SethBRichards/ee453_pcb_N-B-S/README.md

# ee453_pcb_N-B-S
ee453 pcb repo for Nolan, Bennett, and Seth
