SethBRichards/ee453_pcb_N-B-S/ee453_pcb_N-B-S.pdf

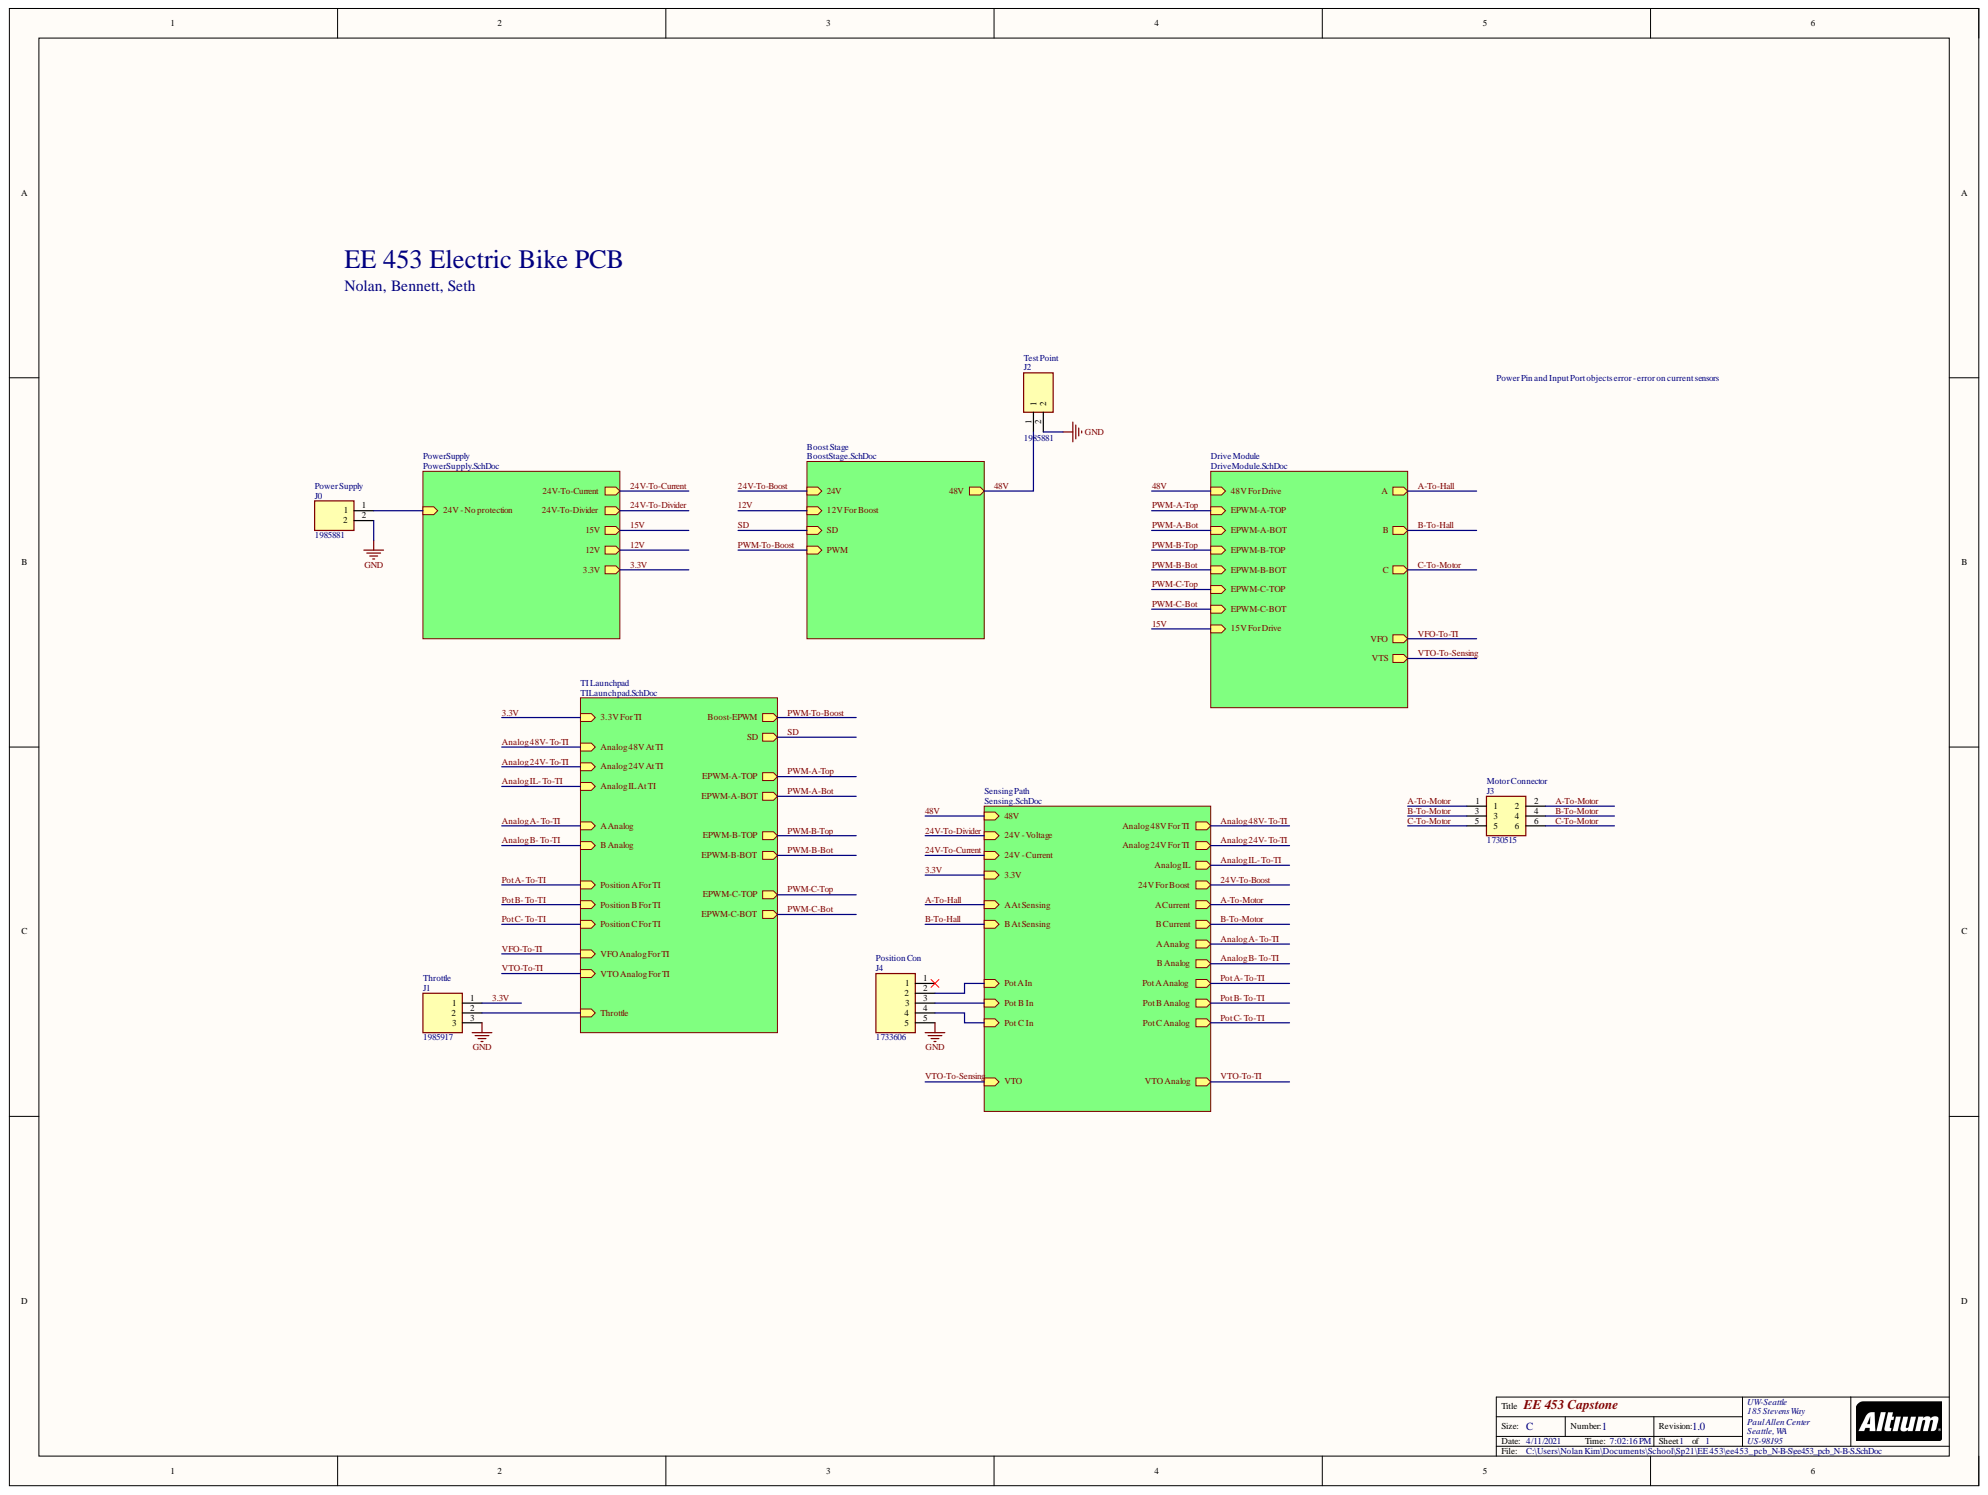
[picture p1: page 1]

EE 453 Electric Bike PCB

Power Pin and InputPort objects error - error on currentsensors

C:\Users\Nolan Kim\Documents\School\Sp21\EE453\ee453_pcb_N-B-S\ee453_pcb_N-B-S.SchDoc

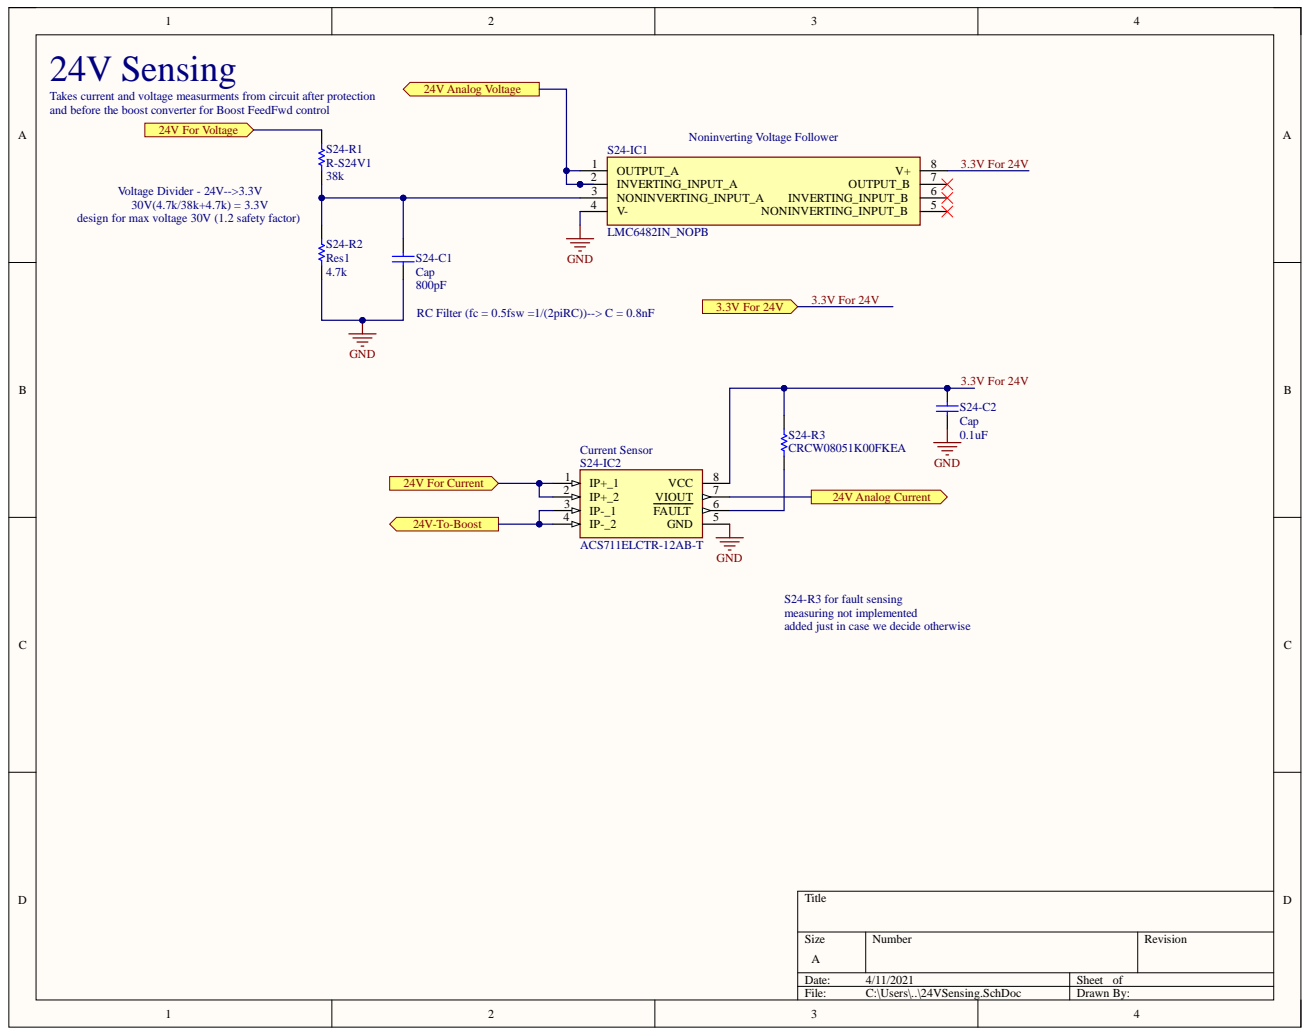
[picture p2: page 2]

Takes current and voltage measurments from circuit after protection
and before the boost converter for Boost FeedFwd control

design for max voltage 30V (1.2 safety factor)

S24-R3 for fault sensing
measuring not implemented
added just in case we decide otherwise

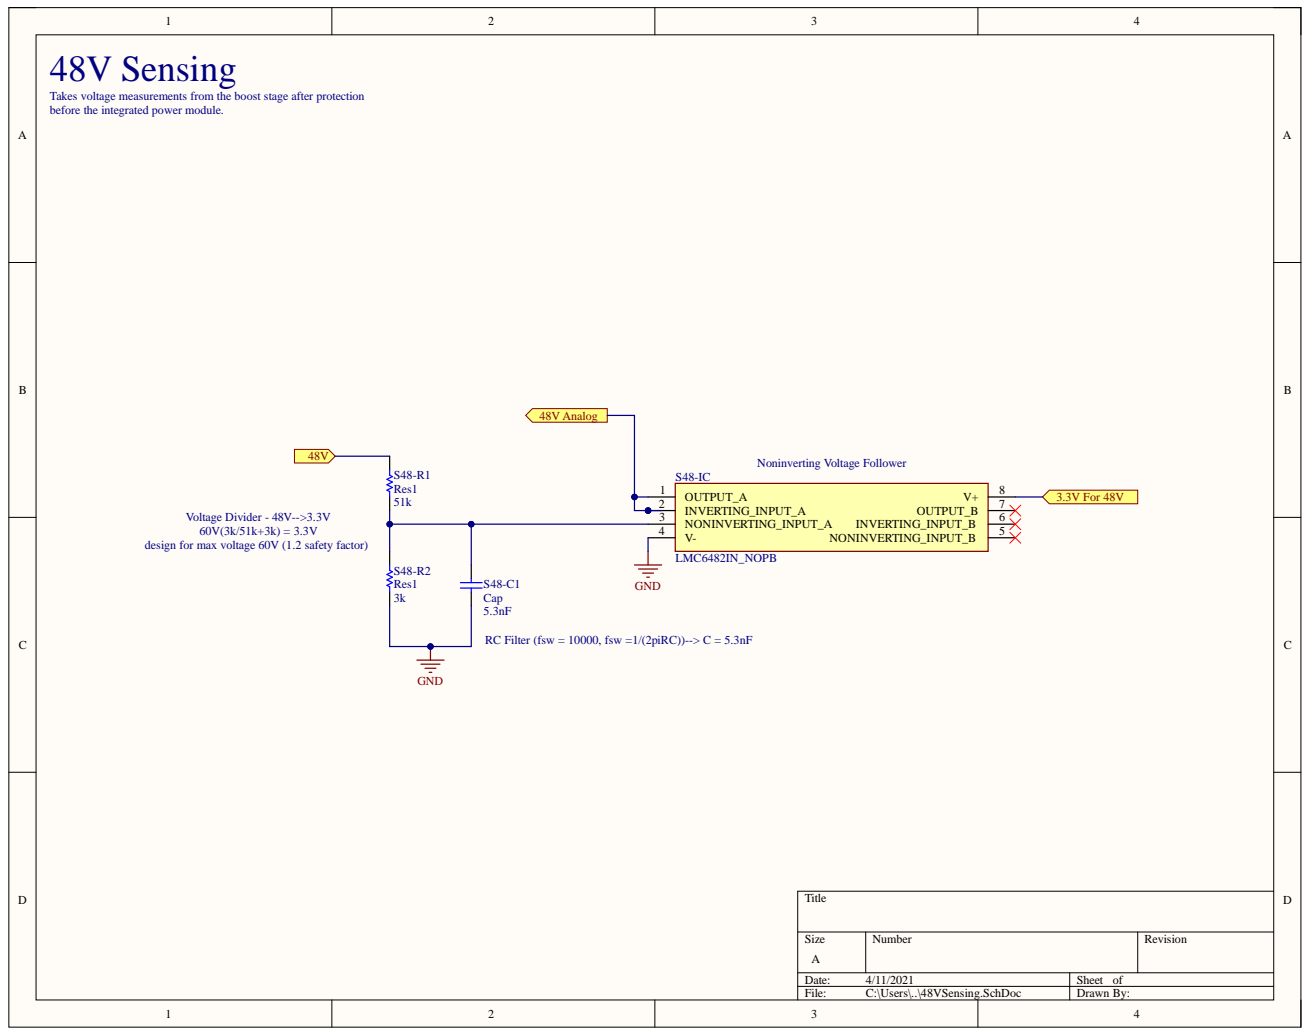
[picture p3: page 3]

48V Sensing Takes voltage measurements from the boos

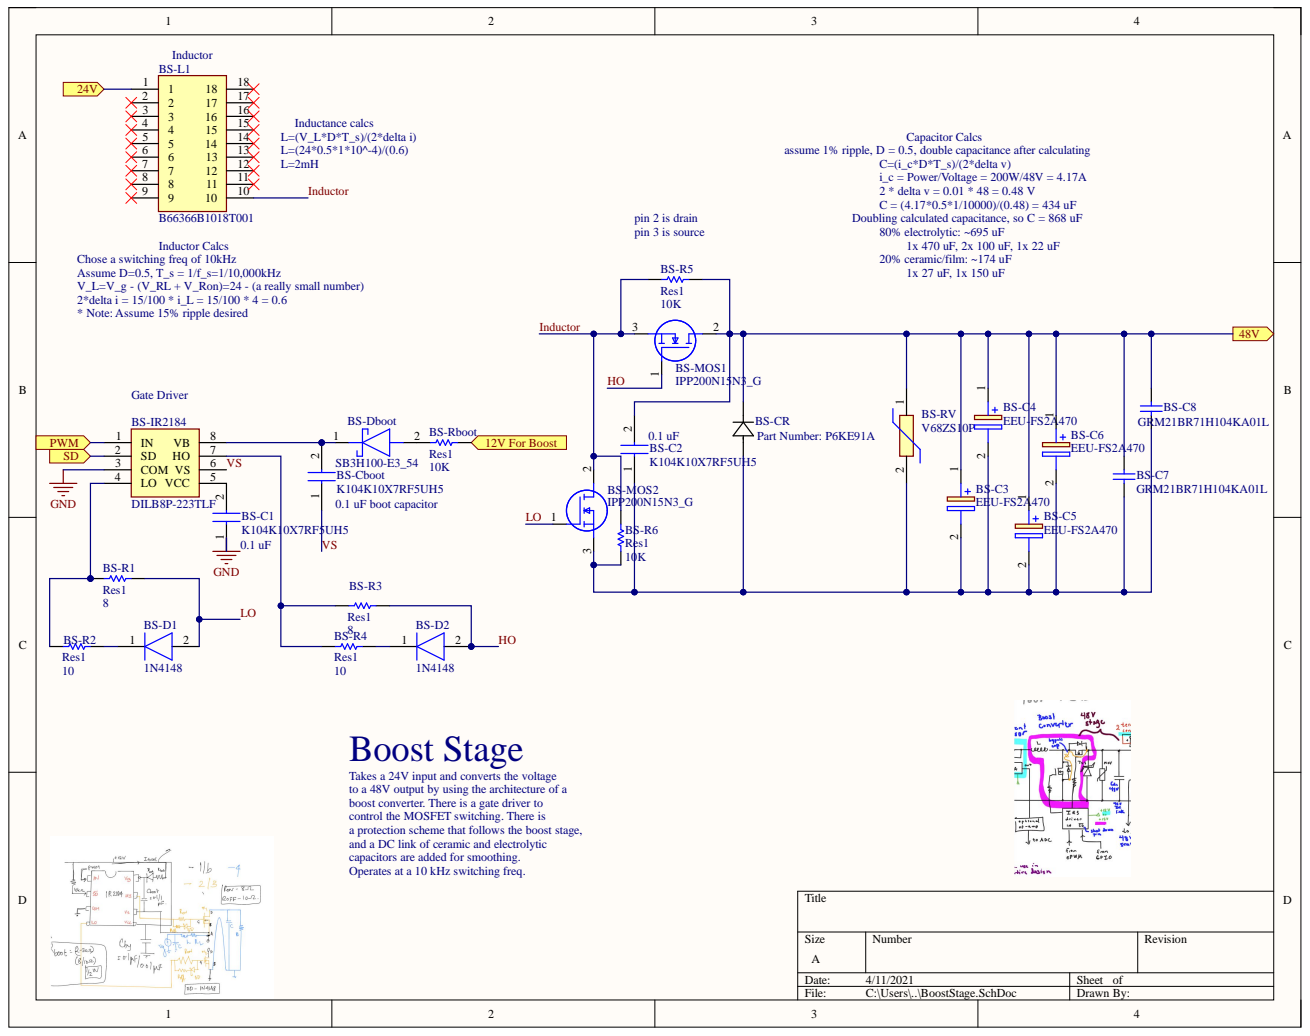
[picture p4: page 4]

assume 1% ripple, D = 0.5, double capacitance after calculating

C=(i_c*D*T_s)/(2*delta v)
i_c = Power/Voltage = 200W/48V = 4.17A
2 * delta v = 0.01 * 48 = 0.48 V
Doubling calculated capacitance, so C = 868 uF
80% electrolytic: ~695 uF
20% ceramic/film: ~174 uF

Chose a switching freq of 10kHz
Assume D=0.5, T_s = 1/f_s=1/10,000kHz
V_L=V_g - (V_RL + V_Ron)=24 - (a really small number)
2*delta i = 15/100 * i_L = 15/100 * 4 = 0.6
* Note: Assume 15% ripple desired

Takes a 24V input and converts the voltage
to a 48V output by using the architecture of a
boost converter. There is a gate driver to
control the MOSFET switching. There is
a protection scheme that follows the boost stage,
and a DC link of ceramic and electrolytic
capacitors are added for smoothing.
Operates at a 10 kHz switching freq.

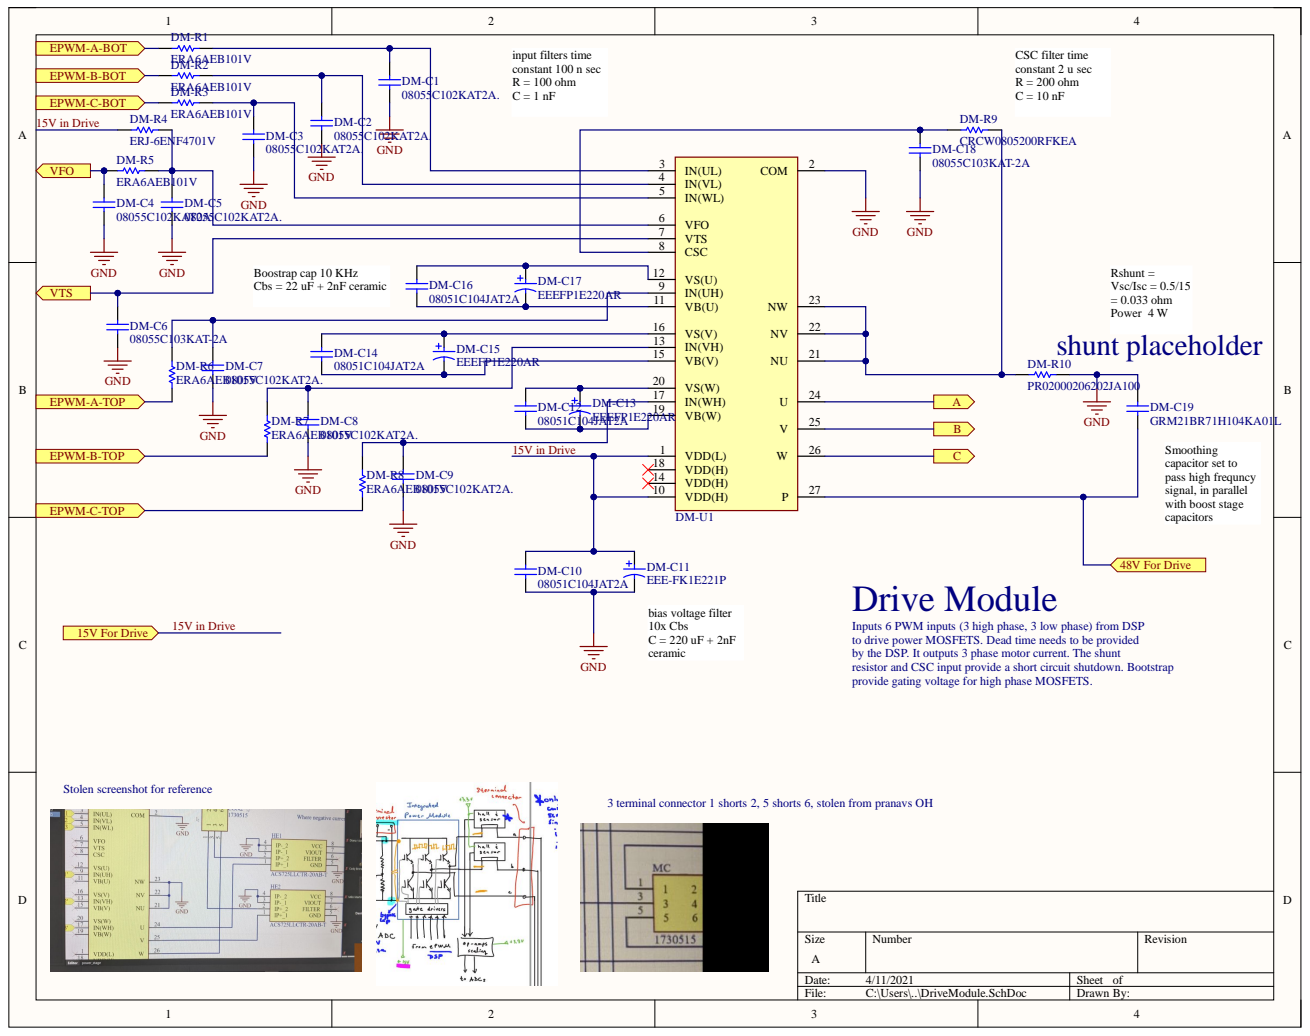
[picture p5: page 5]

D M-C15 D M-C14
08051C104J AT2A | E E E F P1E220A R

age for high pha

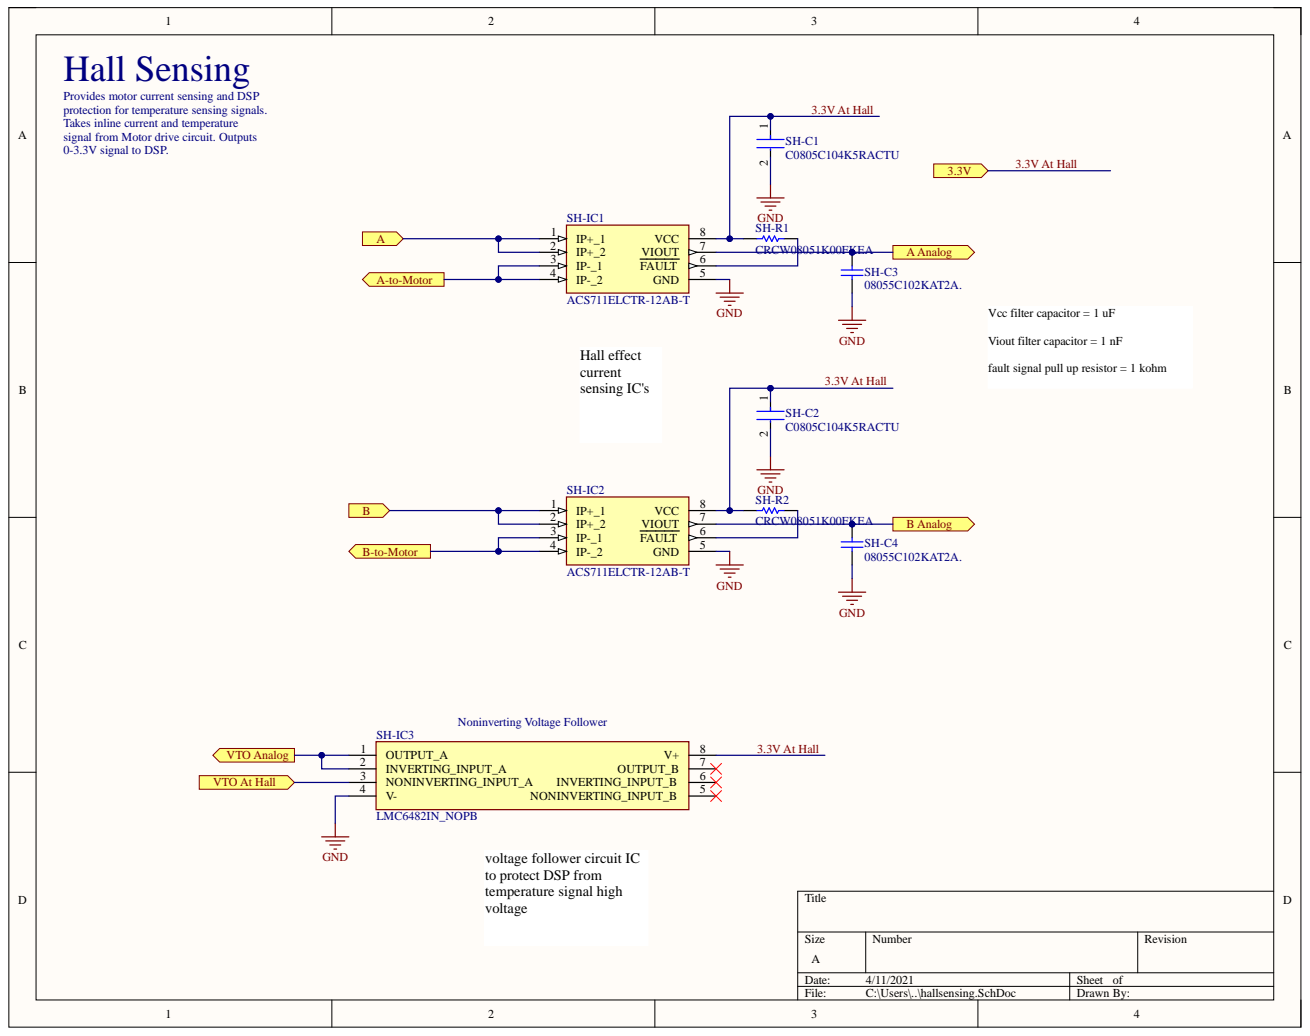
[picture p6: page 6]

Provides motor current sensing and DSP
protection for temperature sensing signals.
Takes inline current and temperature
signal from Motor drive circuit. Outputs
0-3.3V signal to DSP.

Vcc filter capacitor = 1 uF

Viout filter capacitor = 1 nF

fault signal pull up resistor = 1 kohm

voltage follower circuit IC
to protect DSP from
temperature signal high
voltage

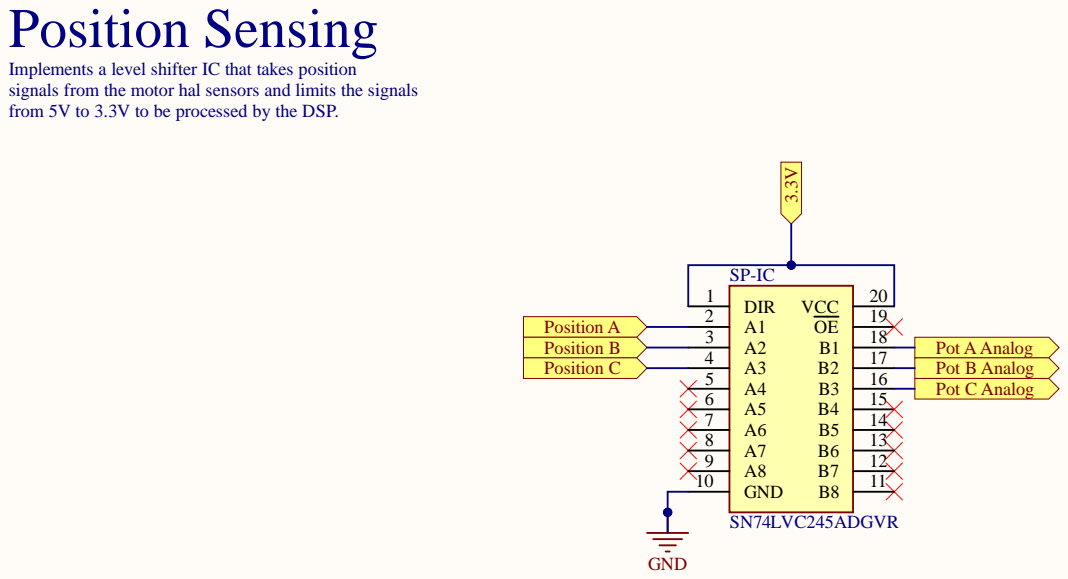
[picture p7: page 7]

Implements a level shifter IC that takes position
signals from the motor hal sensors and limits the signals
from 5V to 3.3V to be processed by the DSP.

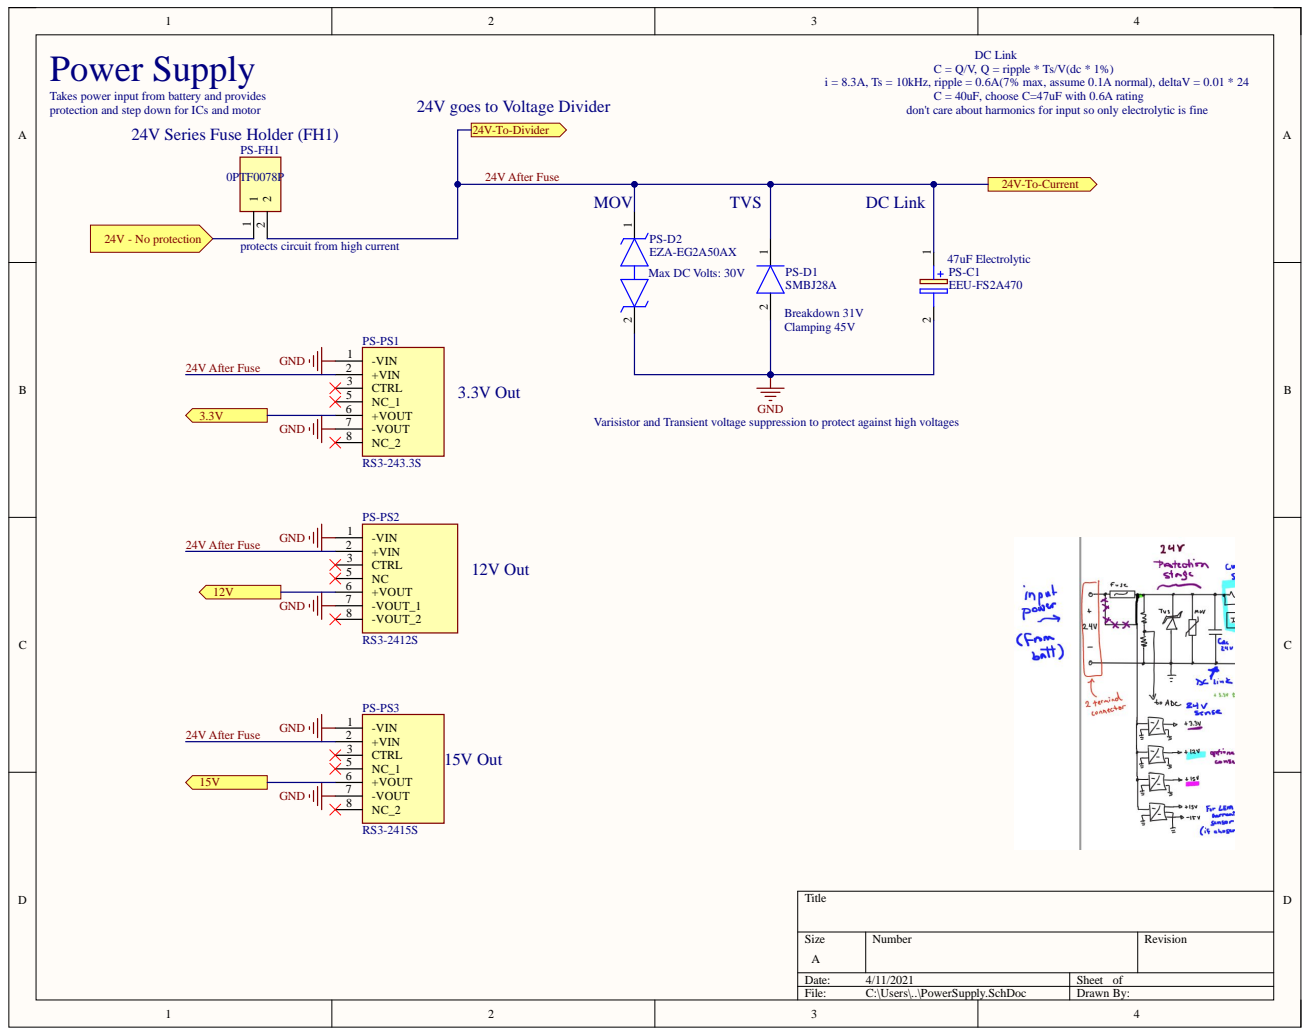
[picture p8: page 8]

i = 8.3A, Ts = 10kHz, ripple = 0.6A(7% max, assume 0.1A normal), deltaV = 0.01 * 24

Takes power input from battery and provides
protection and step down for ICs and motor

24V goes to Voltage Divider

C = 40uF, choose C=47uF with 0.6A rating
don't care about harmonics for input so only electrolytic is fine

protects circuit from high current

Varisistor and Transient voltage suppression to protect against high voltages

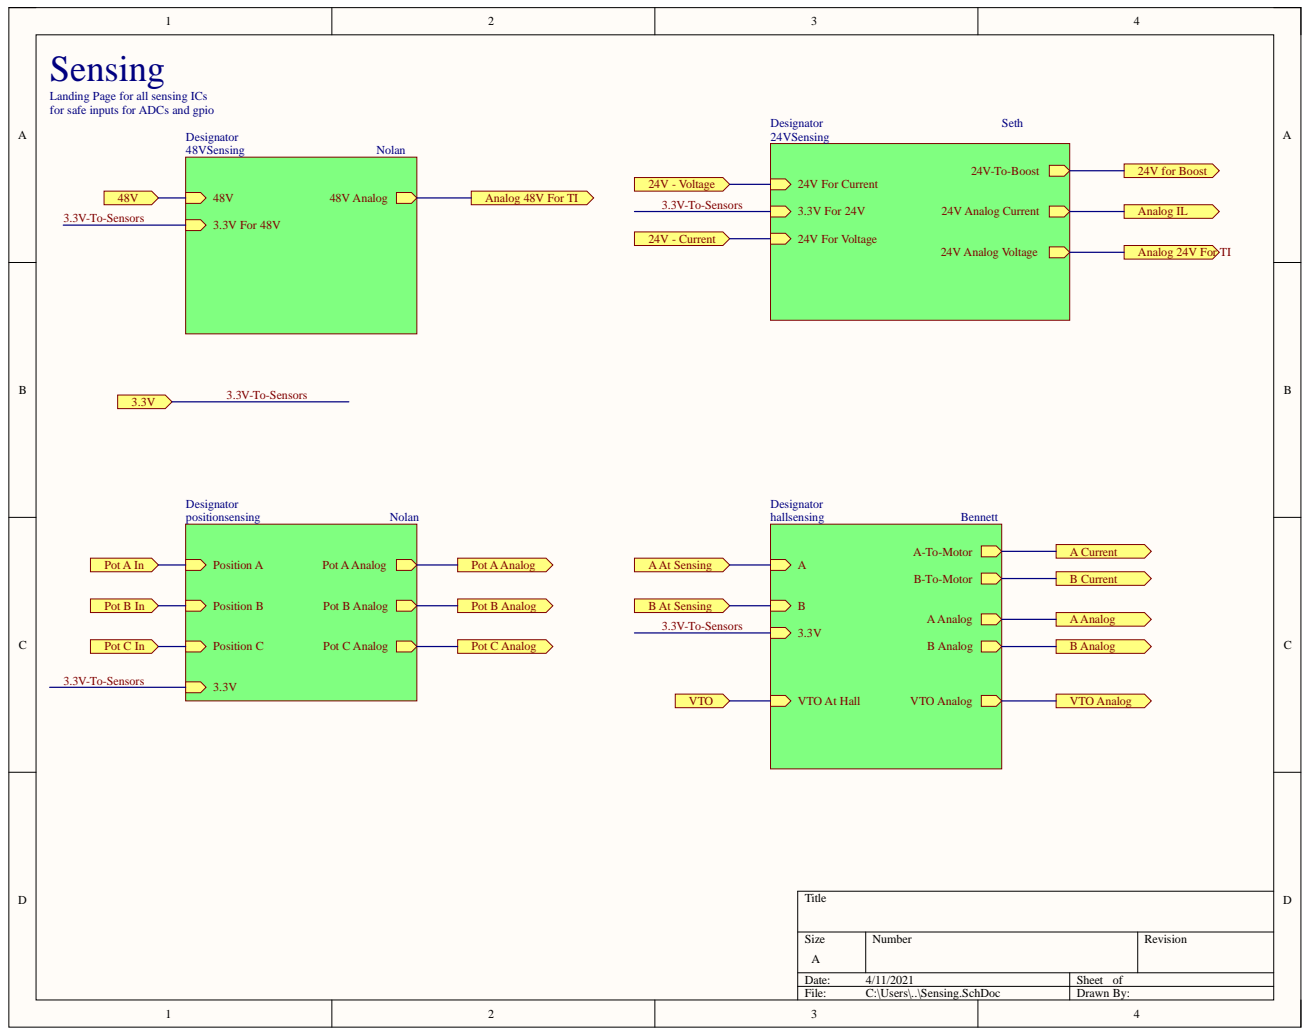
[picture p9: page 9]

Landing Page for all sensing ICs
for safe inputs for ADCs and gpio

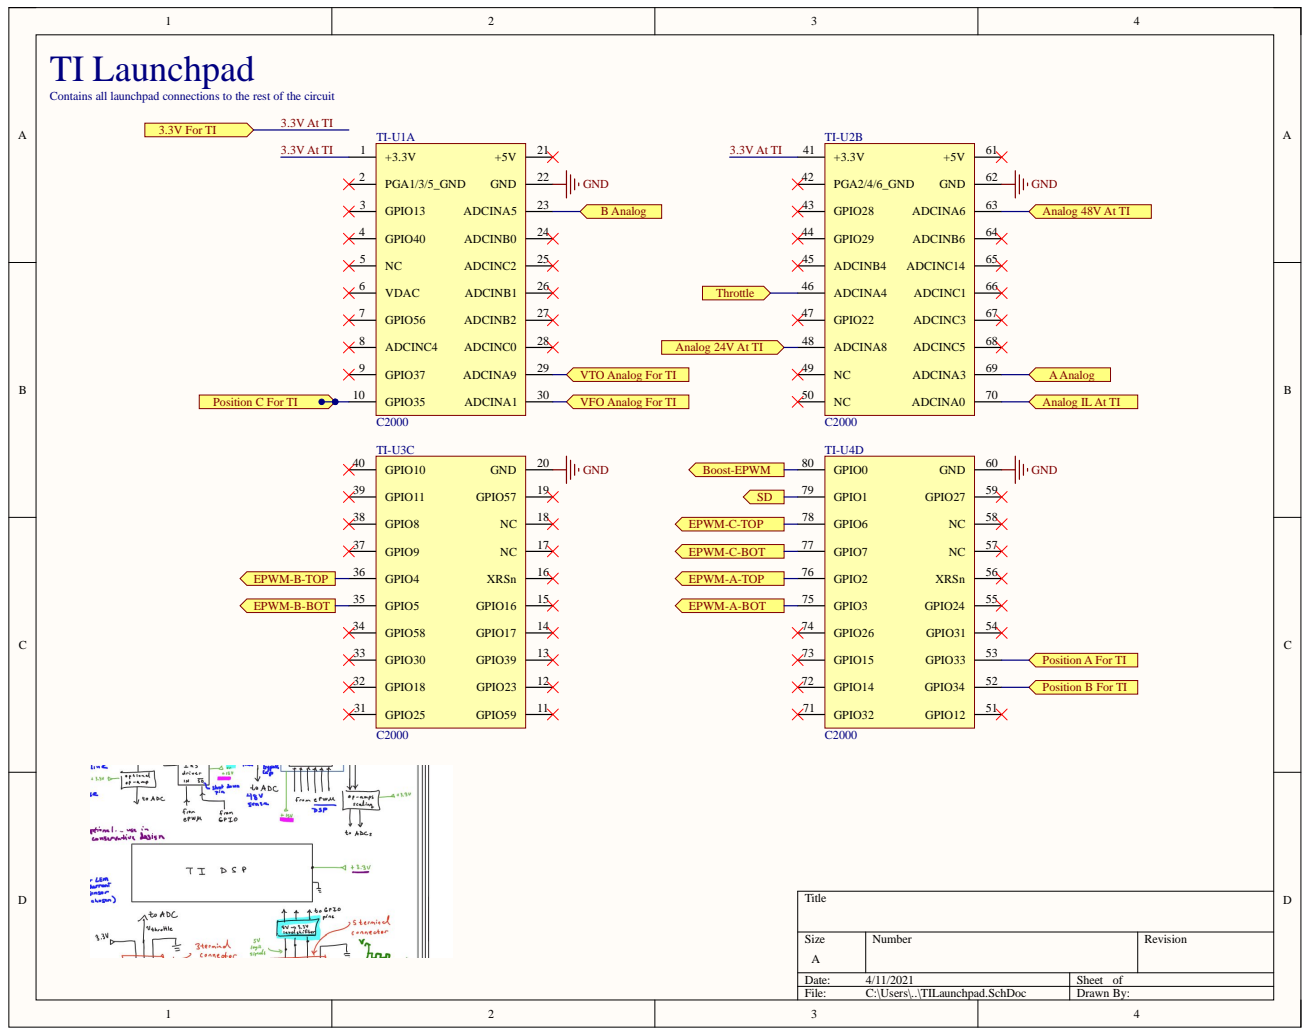
[picture p10: page 10]

Contains all launchpad connections to the rest of the circuit

VTO Analog For TI

VFO Analog For TI

Analog IL At TI

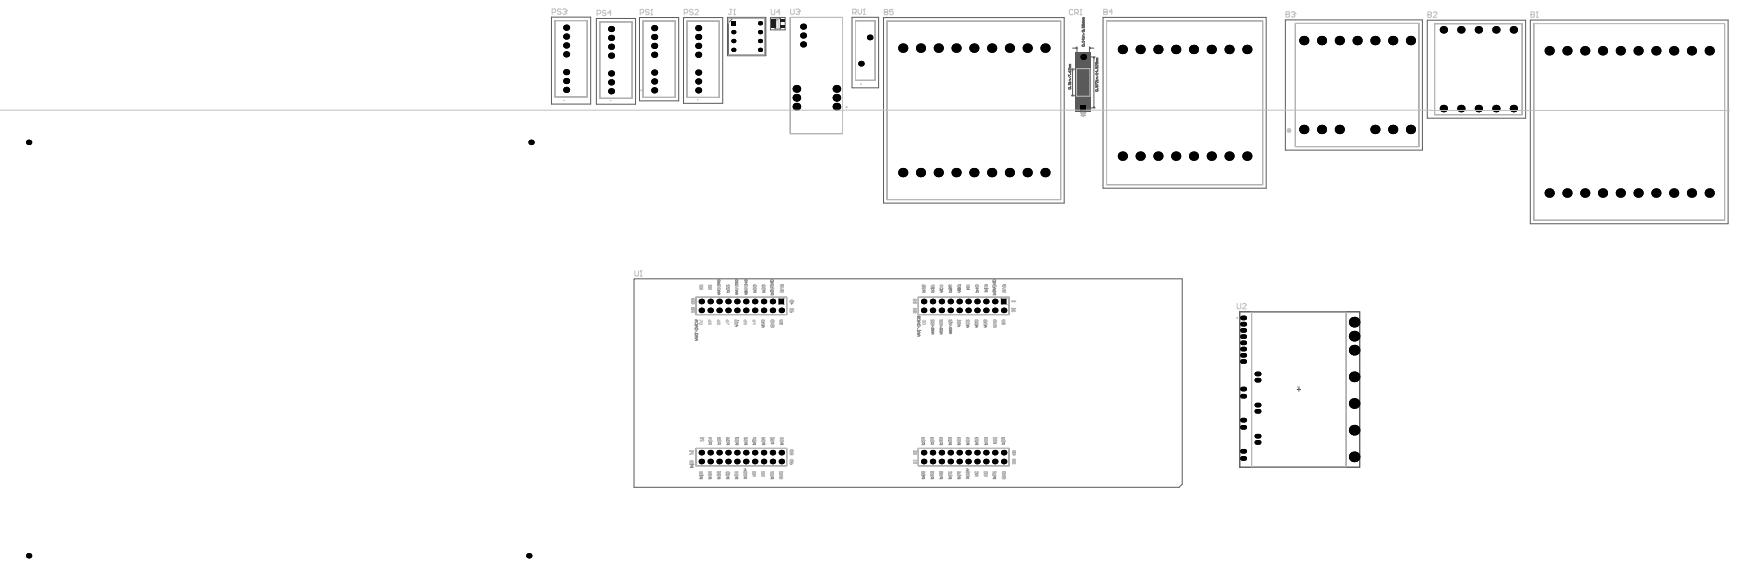
[picture p11: page 11]
