SethBRichards/ee453_pcb_N-B-S/(list of files, drawings)

Other design files:
BoostStage.SchDoc
DriveModule.SchDoc
ee453_pcb_N-B-S.PcbDoc
ee453_pcb_N-B-S.PrjPcb
ee453_pcb_N-B-S.SchDoc
ee_453_yourname.PcbLib
ee_453_yourname.SchLib
hallsensing.SchDoc
positionsensing.SchDoc
PowerSupply.SchDoc
Sensing.SchDoc
TILaunchpad.SchDoc
VoltageSensing.SchDoc
