SethBRichards/ee453_pcb_N-B-S/(commit log)

2021-04-07 Added Altium Files
    Added altium files from template with
    sub circuit schematic files
    [BoostStage.SchDoc, DriveModule.SchDoc, PowerSupply.SchDoc, Sensing.SchDoc, TILaunchpad.SchDoc, ee453_pcb_N-B-S.PcbDoc, ee453_pcb_N-B-S.PrjPcb, ee453_pcb_N-B-S.SchDoc]
2021-04-07 test commit
    [ee453_pcb_N-B-S.PrjPcb, ee453_pcb_N-B-S.SchDoc]
2021-04-07 re-adding files to source
    [PowerSupply.SchDoc, ee453_pcb_N-B-S.PrjPcb]
2021-04-07 added top level entry placements
    [BoostStage.SchDoc, DriveModule.SchDoc, PowerSupply.SchDoc, Sensing.SchDoc, TILaunchpad.SchDoc, ee453_pcb_N-B-S.SchDoc]
2021-04-07 added some power supply stuff
    [PowerSupply.SchDoc, ee453_pcb_N-B-S.SchDoc]
2021-04-07 added jpgs for reference
    [BoostStage.SchDoc, DriveModule.SchDoc, PowerSupply.SchDoc, Sensing.SchDoc, TILaunchpad.SchDoc, ee453_pcb_N-B-S.SchDoc]
2021-04-07 DC link equation
    [BoostStage.SchDoc]
2021-04-07 dc link
    [BoostStage.SchDoc, PowerSupply.SchDoc]
2021-04-07 notes on dc link
    [BoostStage.SchDoc]
2021-04-07 stolen screenshots
    [BoostStage.SchDoc, DriveModule.SchDoc, TILaunchpad.SchDoc]
2021-04-07 finished power supply
    [PowerSupply.SchDoc, ee453_pcb_N-B-S.SchDoc]
2021-04-07 note on op amp
    [Sensing.SchDoc]
2021-04-07 ground -vout for ps
    [PowerSupply.SchDoc, Sensing.SchDoc, TILaunchpad.SchDoc]
2021-04-08 launchpad update
    [TILaunchpad.SchDoc, ee453_pcb_N-B-S.SchDoc]
2021-04-08 dc link update
    [PowerSupply.SchDoc, TILaunchpad.SchDoc]
2021-04-08 finished boost
    [BoostStage.SchDoc]
2021-04-08 Power module started. Inputs and outputs connected. Still working to size and itegrate resistor and capacitors.
    [DriveModule.SchDoc, ee453_pcb_N-B-S.PrjPcb]
2021-04-08 meeting updates
    [24VSensing.SchDoc, 48VSensing.SchDoc, BoostStage.SchDoc, PowerSupply.SchDoc, Sensing.SchDoc, TILaunchpad.SchDoc, ee453_pcb_N-B-S.SchDoc, hallsensing.SchDoc]
2021-04-08 added correct current paths
    [24VSensing.SchDoc, Sensing.SchDoc]
2021-04-08 updated ti ports
    [24VSensing.SchDoc, PowerSupply.SchDoc, TILaunchpad.SchDoc, ee453_pcb_N-B-S.SchDoc]
2021-04-08 gnd update
    [PowerSupply.SchDoc, TILaunchpad.SchDoc]
2021-04-08 added hall sensors
    [24VSensing.SchDoc, 48VSensing.SchDoc, PowerSupply.SchDoc, Sensing.SchDoc, hallsensing.SchDoc]
2021-04-08 added 24V I&V sensing
    [24VSensing.SchDoc, Sensing.SchDoc]
2021-04-08 finally fixed TI
    [TILaunchpad.SchDoc]
2021-04-08 i dont remember
    [TILaunchpad.SchDoc]
2021-04-09 mostly complete drive module
    [DriveModule.SchDoc]
2021-04-09 fixed power supply DC link
    [24VSensing.SchDoc, PowerSupply.SchDoc]
2021-04-09 added sensing paths
    [Sensing.SchDoc, ee453_pcb_N-B-S.SchDoc]
2021-04-09 added net labels
    [24VSensing.SchDoc, PowerSupply.SchDoc, TILaunchpad.SchDoc]
2021-04-09 no comment
    [ee453_pcb_N-B-S.PrjPcb, ee453_pcb_N-B-S.SchDoc]
2021-04-09 updated schematics
    [24VSensing.SchDoc, 48VSensing.SchDoc, BoostStage.SchDoc, ee453_pcb_N-B-S.PrjPcb, ee453_pcb_N-B-S.SchDoc, positionsensing.SchDoc]
2021-04-09 I still don't understand how to match real compents, but this should be a good start.
    [DriveModule.SchDoc]
2021-04-09 Motor current sensing added, still do not understand how to add 'real' parts
    [hallsensing.SchDoc]
2021-04-09 labels
    fixed labels for power supply
    added bypass cap to 24V current
    [24VSensing.SchDoc, PowerSupply.SchDoc, TILaunchpad.SchDoc, ee453_pcb_N-B-S.SchDoc]
2021-04-09 added connecter
    [ee453_pcb_N-B-S.SchDoc]
2021-04-09 added net labels corrected VD 24V
    [24VSensing.SchDoc, PowerSupply.SchDoc, TILaunchpad.SchDoc, ee453_pcb_N-B-S.SchDoc]
2021-04-09 note for 48V sensing
    [48VSensing.SchDoc]
2021-04-09 added power supply for overall
    [ee453_pcb_N-B-S.SchDoc]
2021-04-09 added motor connector
    [ee453_pcb_N-B-S.SchDoc]
2021-04-09 minor update
    [ee453_pcb_N-B-S.SchDoc]
2021-04-10 net labels and ports
    [Sensing.SchDoc, ee453_pcb_N-B-S.SchDoc]
2021-04-10 history update
    [ee453_pcb_N-B-S.PrjPcb]
2021-04-10 added VFO and VTO to sensing
    [ee453_pcb_N-B-S.SchDoc]
2021-04-10 Added protection for VTO
    [DriveModule.SchDoc, Sensing.SchDoc, ee453_pcb_N-B-S.PcbDoc, ee453_pcb_N-B-S.PrjPcb, ee453_pcb_N-B-S.SchDoc, hallsensing.SchDoc]
2021-04-10 updated to use real parts (mostly)
    [DriveModule.SchDoc]
2021-04-10 finished up 48V sensing
    [48VSensing.SchDoc]
2021-04-10 nolan updated
    [48VSensing.SchDoc, BoostStage.SchDoc, Sensing.SchDoc, ee453_pcb_N-B-S.SchDoc, positionsensing.SchDoc]
2021-04-10 fixed boost connections
    [BoostStage.SchDoc]
2021-04-10 changed drive module fault to voltage follower
    [hallsensing.SchDoc]
2021-04-11 fixed some validations
    [24VSensing.SchDoc, 48VSensing.SchDoc, BoostStage.SchDoc, DriveModule.SchDoc, PowerSupply.SchDoc, Sensing.SchDoc, TILaunchpad.SchDoc, ee453_pcb_N-B-S.SchDoc]
2021-04-11 updated protection
    [PowerSupply.SchDoc]
2021-04-11 Hall sensing labelled
    [hallsensing.SchDoc]
2021-04-11 Bennett thinks he's done for the day
    [DriveModule.SchDoc, hallsensing.SchDoc]
2021-04-11 naming convention update
    [48VSensing.SchDoc, BoostStage.SchDoc, PowerSupply.SchDoc, positionsensing.SchDoc]
2021-04-11 missed one component name
    [PowerSupply.SchDoc, TILaunchpad.SchDoc]
2021-04-11 added fault resistor
    [24VSensing.SchDoc, PowerSupply.SchDoc, Sensing.SchDoc, TILaunchpad.SchDoc, ee453_pcb_N-B-S.SchDoc]
2021-04-11 Drive Module labels
    [DriveModule.SchDoc]
2021-04-11 Labels added for Drive Module, Position Sensing, and Hall Sensing.
    [DriveModule.SchDoc, hallsensing.SchDoc, positionsensing.SchDoc]
2021-04-11 updated summaries and added my own
    [48VSensing.SchDoc, BoostStage.SchDoc, DriveModule.SchDoc, TILaunchpad.SchDoc, hallsensing.SchDoc, positionsensing.SchDoc]
2021-04-12 specified switching freq on boost
    [BoostStage.SchDoc, DriveModule.SchDoc]
2021-04-13 meeting updates
    nothing substantial
    [ee453_pcb_N-B-S.PcbDoc]
2021-04-15 updated link
    [TILaunchpad.SchDoc, ee453_pcb_N-B-S.PcbDoc]
2021-04-16 drive module and position sensing updated for Pranav's suggestions.
    [DriveModule.SchDoc]
2021-04-16 fixed resistors
    [TILaunchpad.SchDoc]
2021-04-16 fixed power ports
    [24VSensing.SchDoc, 48VSensing.SchDoc, BoostStage.SchDoc, DriveModule.SchDoc, PowerSupply.SchDoc, Sensing.SchDoc, TILaunchpad.SchDoc, ee453_pcb_N-B-S.SchDoc]
2021-04-16 named position hall sensor connector box J4
    [ee453_pcb_N-B-S.SchDoc]
2021-04-16 turned off mechanical layers
    [ee453_pcb_N-B-S.PcbDoc]
2021-04-17 minor updates
    [ee453_pcb_N-B-S.PcbDoc]
2021-04-17 added reference standoffs
    [ee453_pcb_N-B-S.SchDoc]
2021-04-17 got rid of shunt resistor. got rid of placeholder.
    [DriveModule.SchDoc]
2021-04-17 fixed pin 6 connection
    [BoostStage.SchDoc]
2021-04-17 starting pcb + meeting edits
    [24VSensing.SchDoc, 48VSensing.SchDoc, BoostStage.SchDoc, DriveModule.SchDoc, TILaunchpad.SchDoc, ee453_pcb_N-B-S.PcbDoc, ee453_pcb_N-B-S.SchDoc]
2021-04-18 added power mosfets
    [BoostStage.SchDoc, ee453_pcb_N-B-S.PcbDoc]
2021-04-18 silk update
    [ee453_pcb_N-B-S.PcbDoc]
2021-04-18 added IC footprints and tried to fit all power components on the topside of the board.
    [BoostStage.SchDoc, PowerSupply.SchDoc, ee453_pcb_N-B-S.PcbDoc]
2021-04-18 nothing, idk why theres even a push
    [ee453_pcb_N-B-S.PcbDoc]
2021-04-19 meeting updates
    pcb begins
    [48VSensing.SchDoc, BoostStage.SchDoc, ee453_pcb_N-B-S.PcbDoc]
2021-04-19 power supply stuff for pcb
    [24VSensing.SchDoc, 48VSensing.SchDoc, PowerSupply.SchDoc, Sensing.SchDoc, ee453_pcb_N-B-S.PcbDoc, ee453_pcb_N-B-S.SchDoc, positionsensing.SchDoc]
2021-04-19 moved inductor
    [ee453_pcb_N-B-S.PcbDoc]
2021-04-19 moved fuse for space
    [ee453_pcb_N-B-S.PcbDoc]
2021-04-20 Flipped 24V current sensor to top of board to be on the power layer. Rotated Drive Module IC for layout. Added drive module components to layout. Added all missing footprints. We will likely need to 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
    [24VSensing.SchDoc, BoostStage.SchDoc, DriveModule.SchDoc, PowerSupply.SchDoc, Sensing.SchDoc, VoltageSensing.SchDoc, ee453_pcb_N-B-S.PcbDoc, ee453_pcb_N-B-S.PrjPcb]
2021-04-20 Second update: Renamed 24/48 voltage sensing schematic to "voltage sensing" with prefix "SV". Started building boost and wiring circuit. Modified boost circuit by removing source to drain resistor.
    [BoostStage.SchDoc, ee453_pcb_N-B-S.PcbDoc, positionsensing.SchDoc]
2021-04-20 finished laying out the components
    [BoostStage.SchDoc, VoltageSensing.SchDoc, ee453_pcb_N-B-S.PcbDoc]
2021-04-20 Moved boost capacitors to shorten critical loops (BS-C1 and DM-C19
    [ee453_pcb_N-B-S.PcbDoc]
2021-04-20 seth pcb
    launchpad pins
    rotated drive module
    reworked boost stage
    changed ground plane to signal
    [BoostStage.SchDoc, TILaunchpad.SchDoc, ee453_pcb_N-B-S.PcbDoc, ee453_pcb_N-B-S.SchDoc]
2021-04-20 added net labels to drive module
    [DriveModule.SchDoc]
2021-04-21 I think everything is connected. It isn't pretty, but it should run.
    [BoostStage.SchDoc, DriveModule.SchDoc, PowerSupply.SchDoc, Sensing.SchDoc, TILaunchpad.SchDoc, ee453_pcb_N-B-S.PcbDoc, ee453_pcb_N-B-S.SchDoc, hallsensing.SchDoc]
2021-04-21 viewing history
    [ee453_pcb_N-B-S.PcbDoc]
2021-04-21 added testpoints
    testpoints, increased power width, added polarity
    [ee453_pcb_N-B-S.PcbDoc]
2021-04-21 added more testpoints
    [ee453_pcb_N-B-S.PcbDoc]
2021-04-22 added polarity
    [BoostStage.SchDoc, DriveModule.SchDoc, ee453_pcb_N-B-S.PcbDoc]
2021-04-22 Changed from fill to polygon pours. Shifted silk screens and corrected errors.
    [BoostStage.SchDoc, DriveModule.SchDoc, ee453_pcb_N-B-S.PcbDoc, ee453_pcb_N-B-S.PrjPcb]
2021-04-22 update history
    [ee453_pcb_N-B-S.PcbDoc]
2021-04-25 Final PCB layout
    [ee453_pcb_N-B-S.PcbDoc]
2021-04-25 Added Gerber and Drill files
    [ee453_pcb_N-B-S.GBL, ee453_pcb_N-B-S.GBO, ee453_pcb_N-B-S.GBP, ee453_pcb_N-B-S.GBS, ee453_pcb_N-B-S.GKO, ee453_pcb_N-B-S.GM1, ee453_pcb_N-B-S.GTL, ee453_pcb_N-B-S.GTO]
2021-04-26 Gerber and Drill files to be sent off.
    [ee453_pcb_N-B-S.GBL, ee453_pcb_N-B-S.GBO, ee453_pcb_N-B-S.GBP, ee453_pcb_N-B-S.GBS, ee453_pcb_N-B-S.GTL, ee453_pcb_N-B-S.GTO, ee453_pcb_N-B-S.GTP, ee453_pcb_N-B-S.GTS]
